ewerd/ECE_411_Team2_EpicDiceRoller/README.md

# ECE_411_Team2_EpicDiceRoller
ECE 411 Team 2 Practicum Project
