ewerd/ECE_411_Team2_EpicDiceRoller/docs/Presentation/ECE 411 Final Project Presentation.pdf

# Epic Dice Roller

## Designed and created by: Braden Harwood, Michael Weston, Stephen Short, Drew Seidel (Team 2 - ECE 411 -Fall 2021)

# Problem

Some common problems of ordinary dice…

- They are easy to lose
- Geometrical problems cause many sided dice to be very difficult to make and read
- They lack an interactive and dynamic way of revealing your roll and its implications on the game (i.e green flashing on a good roll, red on a bad)
- They lack history of dies rolled in case of forgetfulness
- They lack the ability to change the number of sides on a whim, leading one to need to own many dice sets

A positive attributes of dice that we don’t want to lose in our design:

- Hands on, the ability to physically feel, and roll dice by shaking
- Random result generation

# Vision and Motivation

The goal of our end product is to provide a fun, unique, and engaging way to roll dice for the majority of games that require dice, without eliminating the iconically unique feel of rolling the dice by means of shaking. The product is meant to serve as:

- An efficient and effective means of rolling a variety die sizes, as well as well as the number of die rolled, such that the device can be interchanged for traditional die on the vast majority of common games
- A novelty product. The Epic Dice Roller intends to enhance the dice rolling experience, giving the user fun and innovative feedback, methods for rolling, and methods for changing die size and number of die
- Provides a retro visual aesthetic, feel, and means of interacting with the device, without detracting from the positive features of traditional dice that we all know and love

# Objectives

By the end of this project, the goal was to have a not only functional, but nearing ready to move to production product design with a corresponding prototype to demonstrate that this is the case. The product we will unveil today has met the following objectives:

- Electrical design, functionality, and layout is functional and sound
- Power supply to device (9V battery) is simple, and accessible, and replaceable
- Device prototype is user friendly
- Demonstrates the ability to roll up to 9 dice at once
- Demonstrates an ability to be programmed via ICSP for firmware updates
- Demonstrates the ability to have the user change number of die rolled
- Demonstrates the ability to have the user change the dice size (d4, d6, d8, d10, d20, d100)
- Demonstrates that the user can roll dice using three different methods

# Alternatives

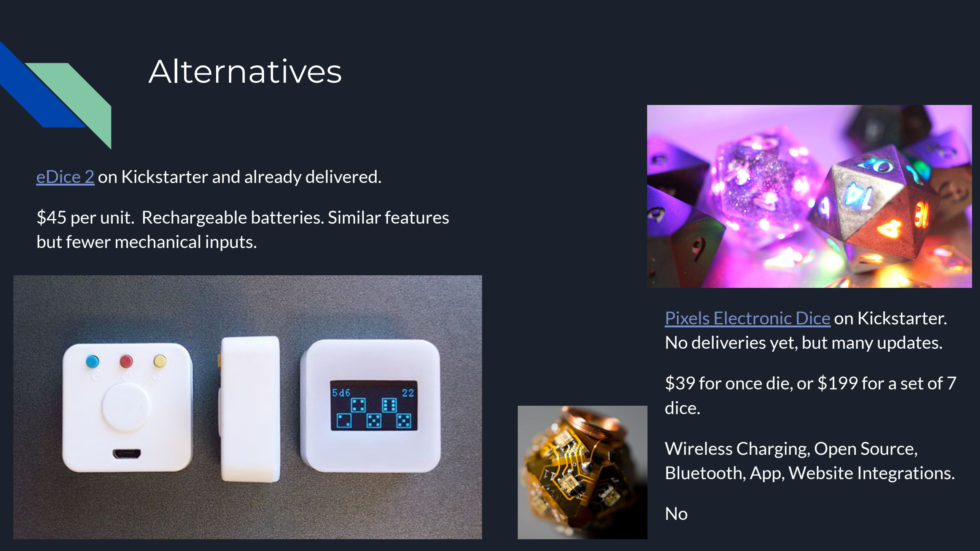
[picture p12: page 5]

eDice 2 (https://www.kickstarter.com/projects/1758784647/edice-2-an-universal-electronic-dice-for-tabletop-games) on Kickstarter and already delivered.

$45 per unit. Rechargeable batteries. Similar features but fewer mechanical inputs.

Pixels Electronic Dice (https://www.kickstarter.com/projects/pixels-dice/pixels-the-electronic-dice/) on Kickstarter. No deliveries yet, but many updates.

$39 for once die, or $199 for a set of 7 dice.

Wireless Charging, Open Source, Bluetooth, App, Website Integrations.

No

# Requirements

In designing this products, we set out the following goals:

Must:
- Simulate up to 9 dice at once
- Display total of dice
- Be able to preview size of dice and number of dice the user will be rolling
- Be powered from a batter
- Use a microprocessor

Should:
- Mount our microprocessor on our own PCB rather than a daughter board
- Have one compact PCB for the entire design
- Be programmable via on-board ICSP circuitry
- Provide users with at least three methods of dice rolling

May:
- Provide user with the individual result of each dice after a rol
- Allow the user to roll ‘fudge’ dice
- Display previous rolls.
- Have an enclosure.

We are two years ahead of schedule...
- Implement bluetooth to phone application to reveal roll
- Flashing LEDs on PCB
- Speaker on PCB for noise
- Voice activated

# Our Approach

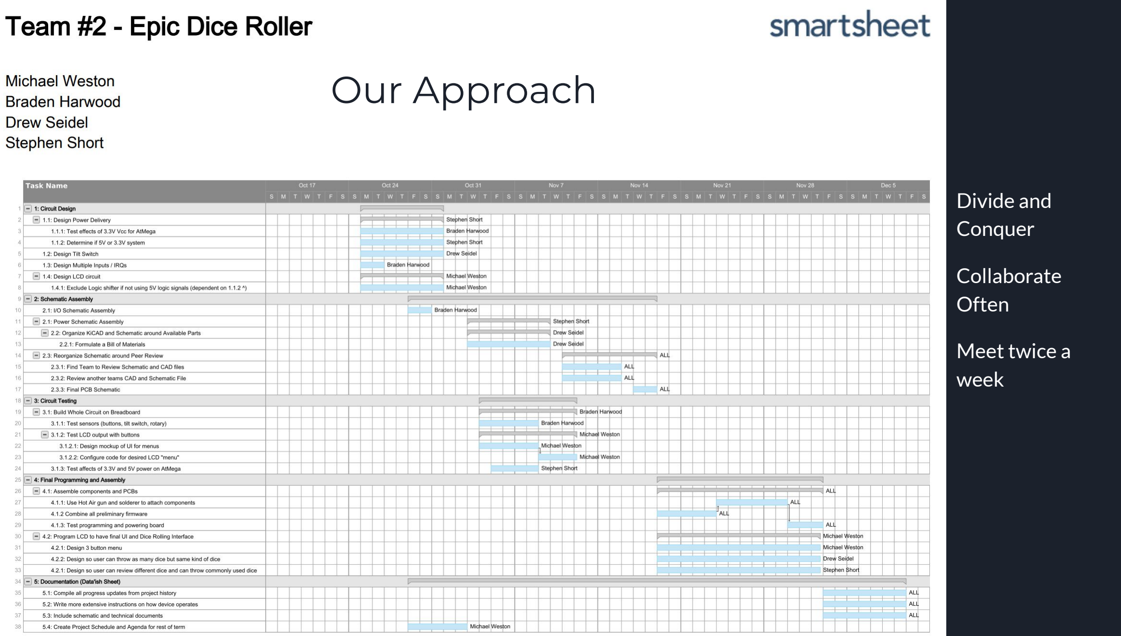
[picture p13: page 7]

Divide and
Conquer

Collaborate
Often

Meet twice a
week

# L0 Block Diagram

# L1 Block Diagram

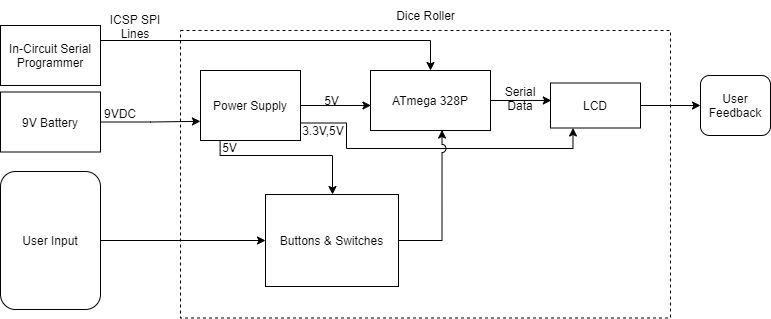
[picture p14: figure]

# Design - I/O and Chip Selection

Given the I/O components we selected, we elected to use the ATmega328P, given its cost, number of I/O pins, number of interrupt pins, and voltage specifications.

Our I/O circuits can be broken down into the following components/subsections.

Sensors:

- A toggle switch
- A single pole single throw power switch
- A single pole double throw toggle switch
- Four pushbuttons
- A rotary encoder with a top pushbutton
- A tilt switch

Actuator:

- An LCD screen

# Push Button

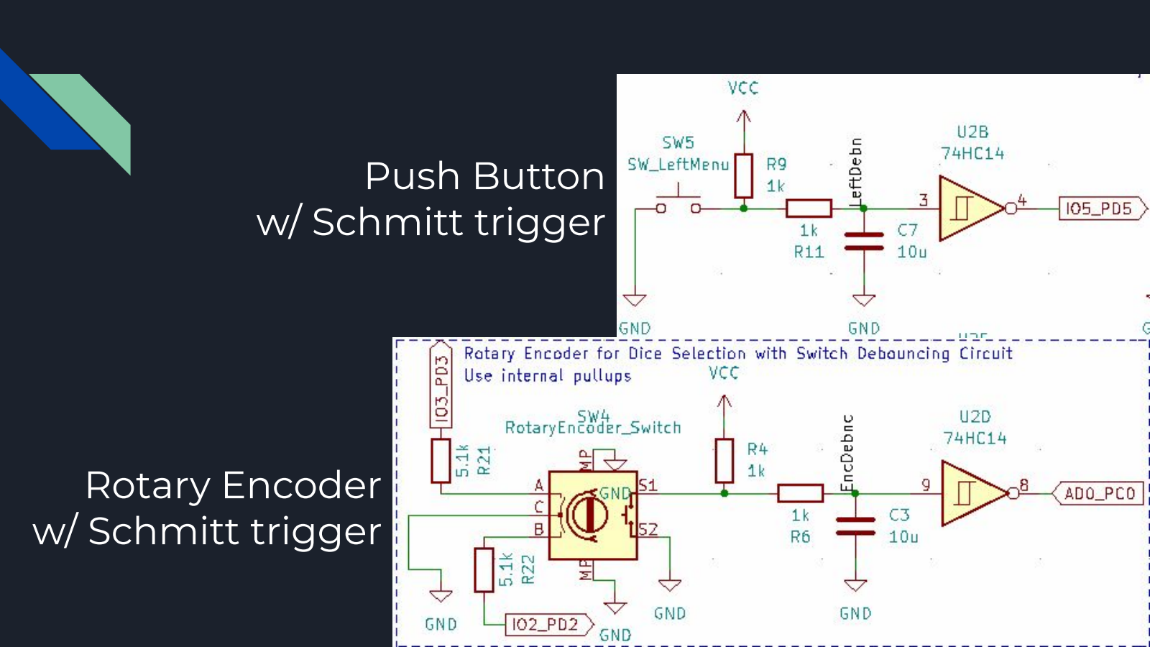
[picture p15: page 11]

# w/ Schmitt trigger

# Rotary Encoder w/ Schmitt trigger

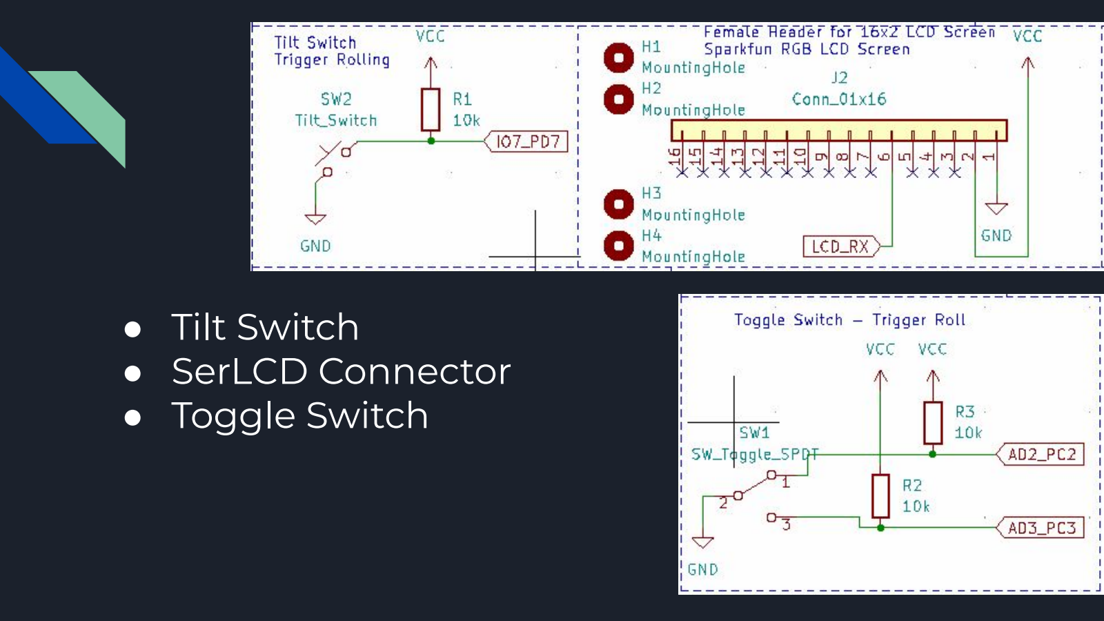
[picture p16: page 12]

# - Tilt Switch - SerLCD Connector - Toggle Switch

# ATMega328P

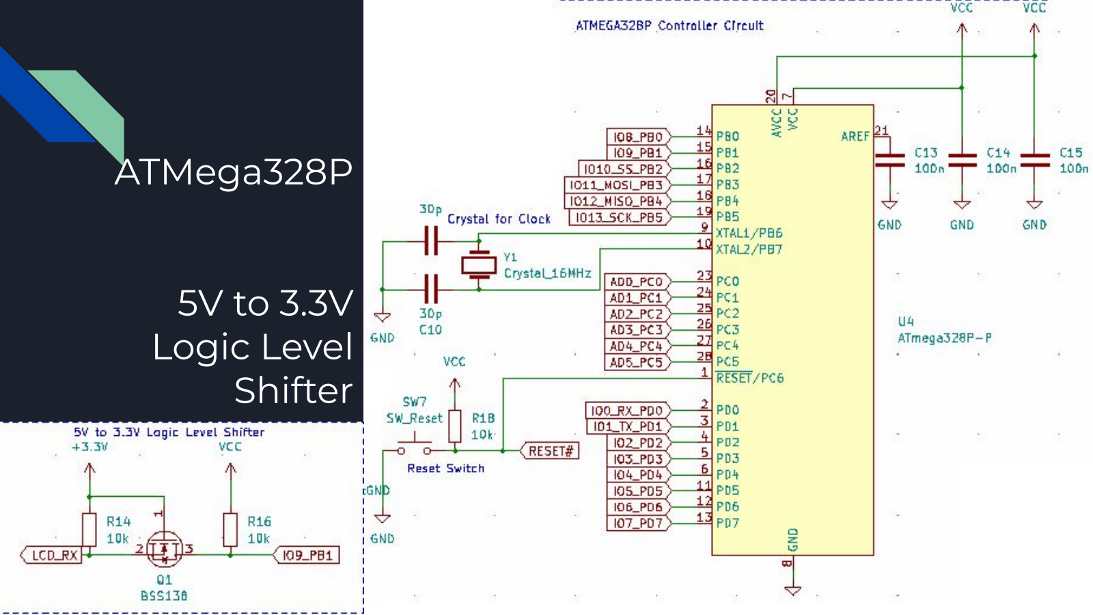
[picture p17: page 13]

# 5V to 3.3V Logic Level Shifter

# Design - Power Supply

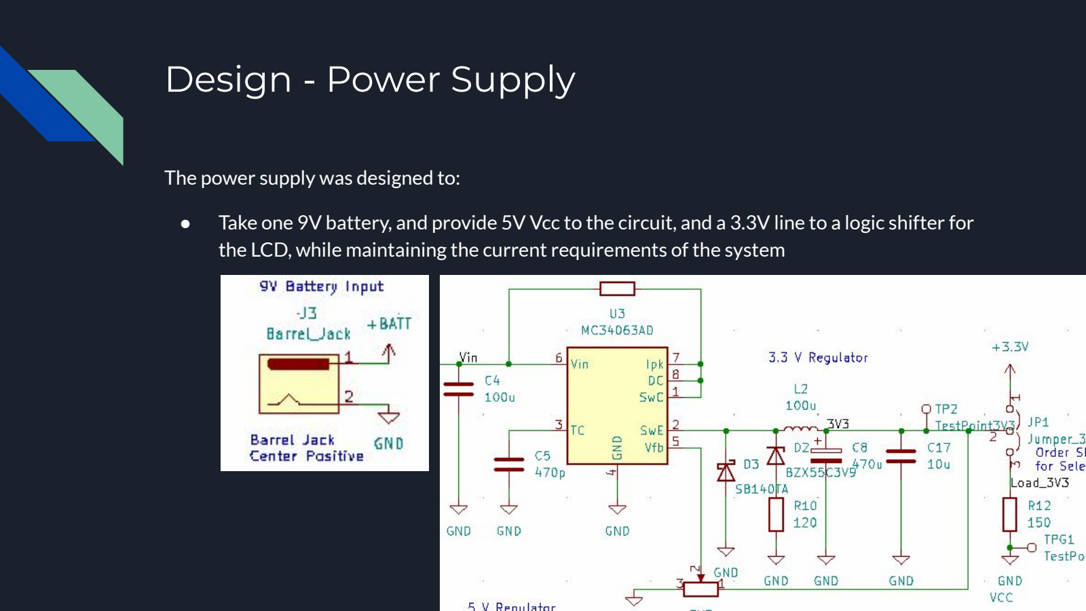
[picture p18: page 14]

The power supply was designed to:

- Take one 9V battery, and provide 5V Vcc to the circuit, and a 3.3V line to a logic shifter for the LCD, while maintaining the current requirements of the system

I am thinking we

# Implementation and Integration

# - Used LTSpice to simulate power supply

- Built sub circuits on breadboards for testing.

## - Power supply - Buttons & Schmitt trigger - Rotary Encoder - Tilt Switch - Logic Level Shifter and SerLCD screen

# Layout

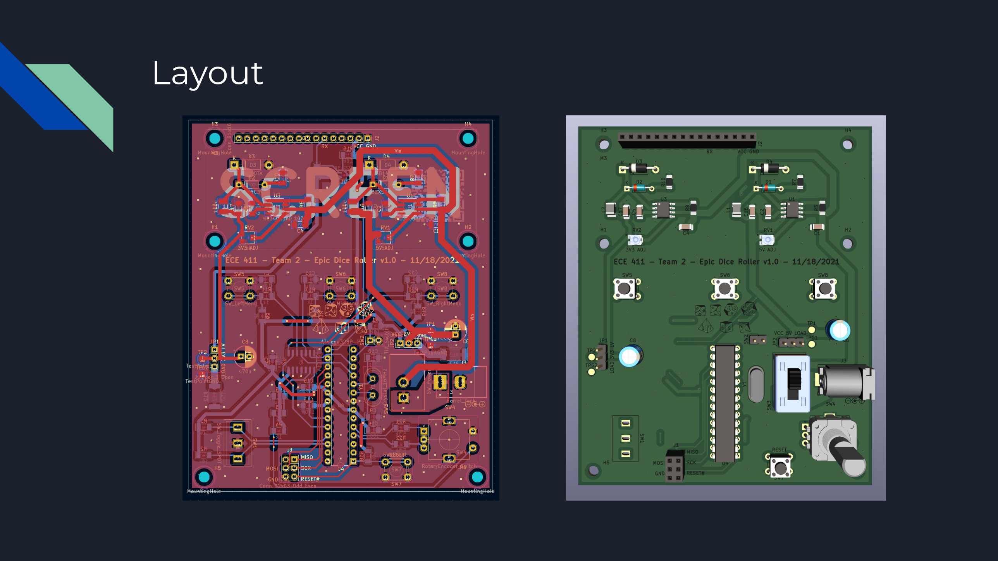
[picture p19: page 16]

# Bill of Materials

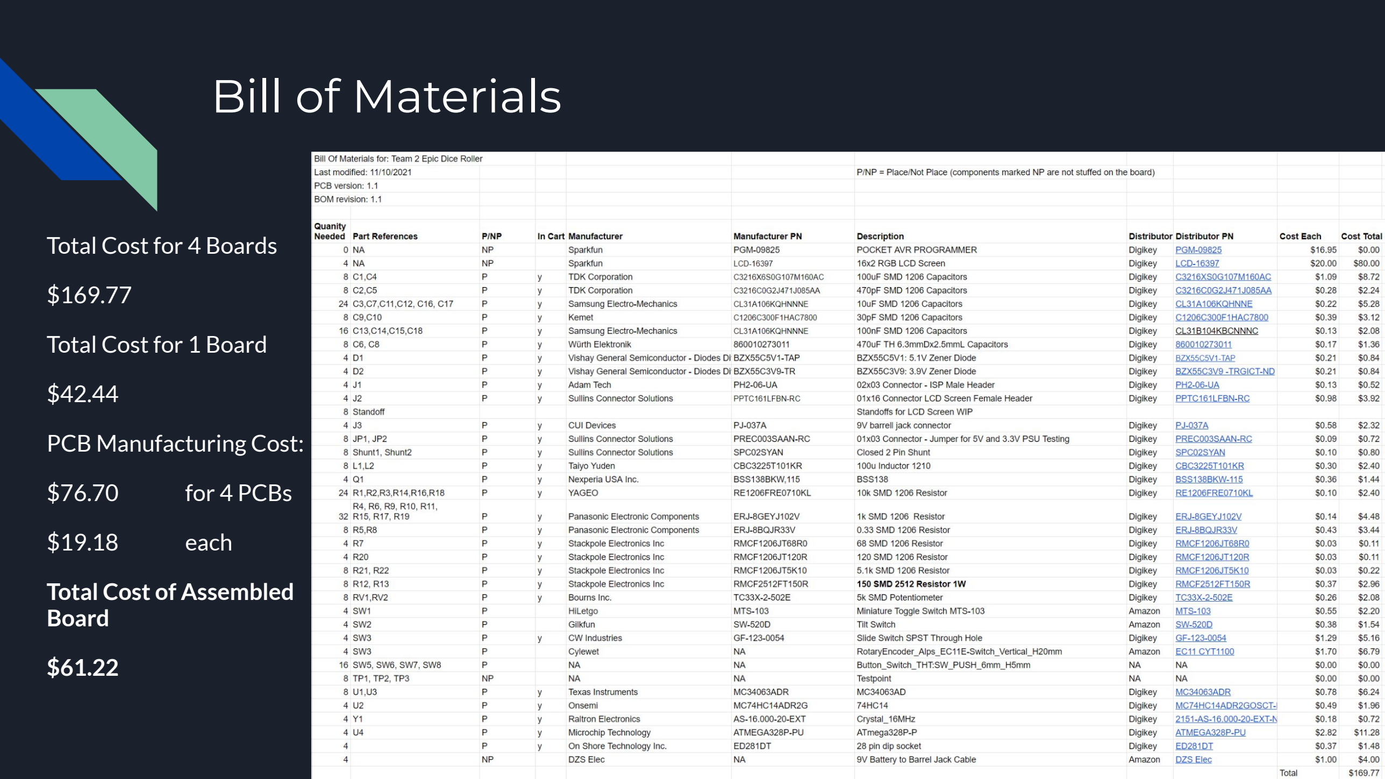
[picture p20: page 17]

Total Cost for 4 Boards

$169.77

Total Cost for 1 Board

$42.44

PCB Manufacturing Cost:

$76.70 | for 4 PCBs
$19.18 | each

Total Cost of Assembled
Board

$61.22

# Firmware - Code Overview

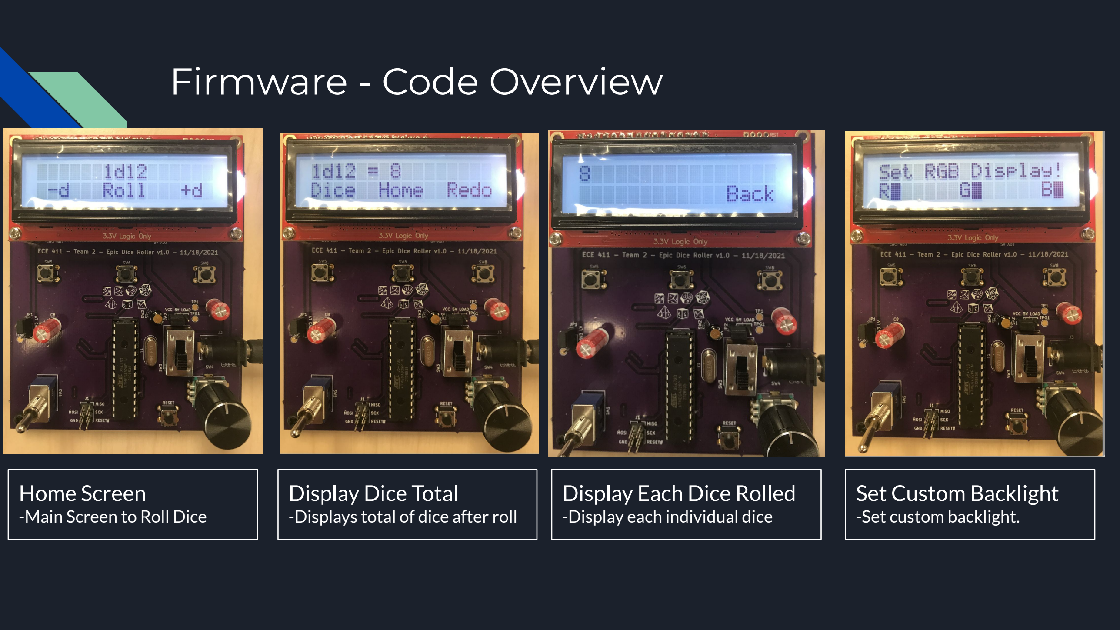
[picture p21: page 18]

Home Screen
-Main Screen to Roll Dice

Display Dice Total
-Displays total of dice after roll

Display Each Dice Rolled
-Display each individual dice

Set Custom Backlight
-Set custom backlight.

# IP and Prior Work

Braden’s Dice Roller v0

Arduino Bootloader (https://www.arduino.cc/en/Hacking/Bootloader?from=Tutorial.Bootloader) and IDE (https://www.arduino.cc/en/software)

Software Libraries: Entropy, (https://code.google.com/archive/p/avr-hardware-random-number-generation/) AltSoftSerial, (https://github.com/PaulStoffregen/AltSoftSerial) RotaryEncoder, (https://github.com/mathertel/RotaryEncoder) EnableInterrupt (https://github.com/GreyGnome/EnableInterrupt)

Sparkfun Logic Level Converter (https://www.sparkfun.com/products/12009)

Andrew Greenberg’s atmega328p Circuit Example (https://github.com/andrewgreenberg/eaglecad-workshop/tree/master/atmega328p-example)

Reference Design from MC34063ADR Datasheet

KiCAD v5.99 (https://www.kicad.org/)

LTSpice XVII (https://www.analog.com/en/design-center/design-tools-and-calculators/ltspice-simulator.html)

# Testing

We tested during each phase of the design process to ensure that the steps we were taking would yield a successful prototype:

Pre-PCB Development Stage:

- Tested the power supply design on breadboard
- Tested tilt switch, other I/O components on breadboard
- Developed a fully working breadboard prototype

During PCB Schematic and Layout Development:

- Multiple iterations, layouts by group members
- ERC tests
- DRC tests
- Design reviews

During PCB Bringup

- Soldered power supply first and tested to ensure success on each board
- Soldered I/O and tested electrical continuity, and validity of input/output functionality from sensors
- Tested electrical functionality of Rx line to LCD pins and it’s voltage level

Post PCB Bringup (Firmware Testing)

- Tested all modes to ensure functionality was as expected
- Interrogation of bugs
- Ensured that the random numbers were being generated, and die numbers were within range

# Results - Power Supply - 3.3V Output

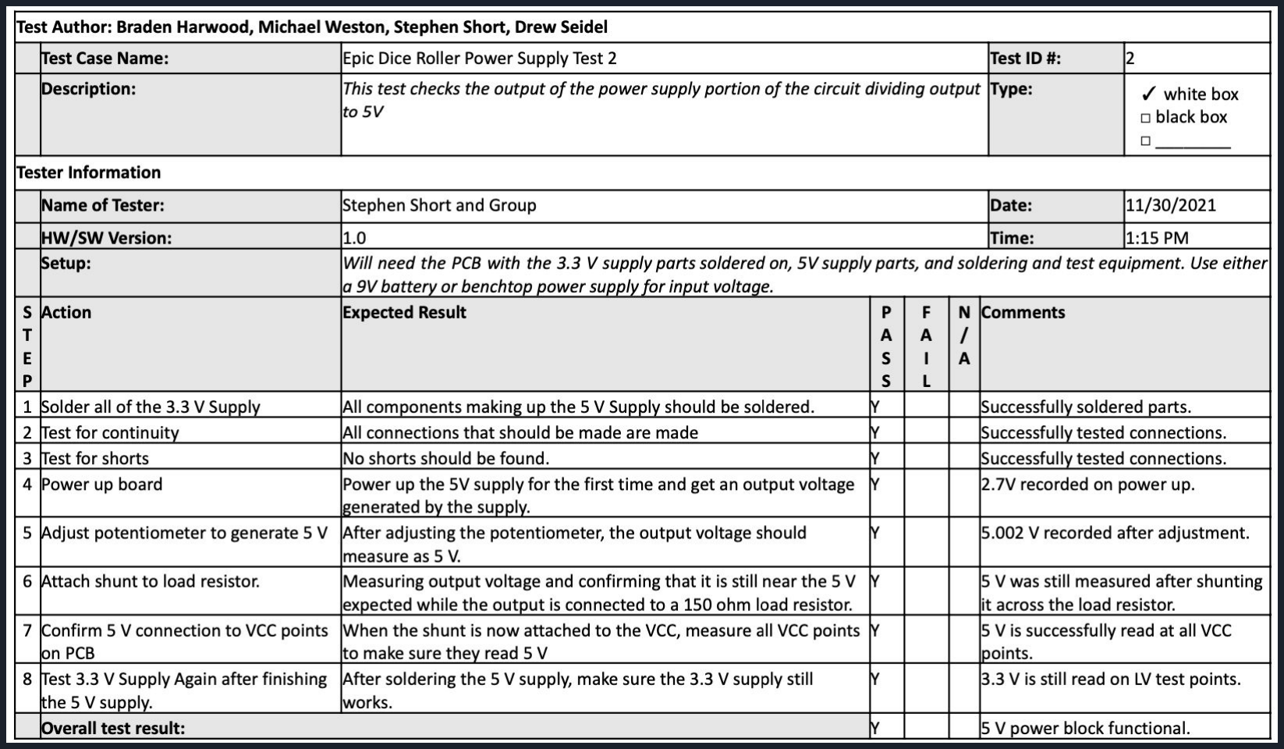
[picture p22: figure]

# Results - Power Supply - 5V Output

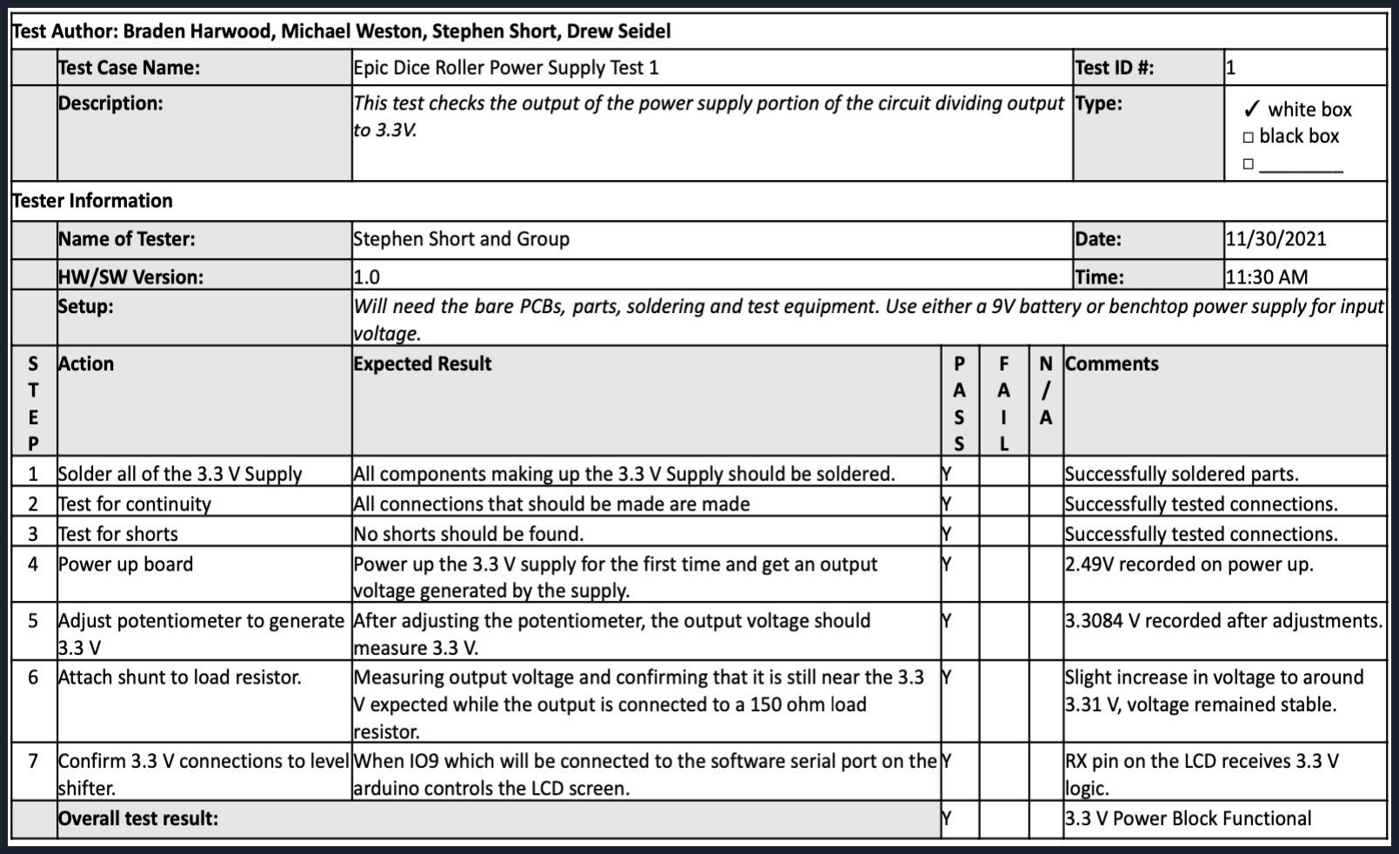
[picture p23: figure]

# Results - I/O Electrical Functionality

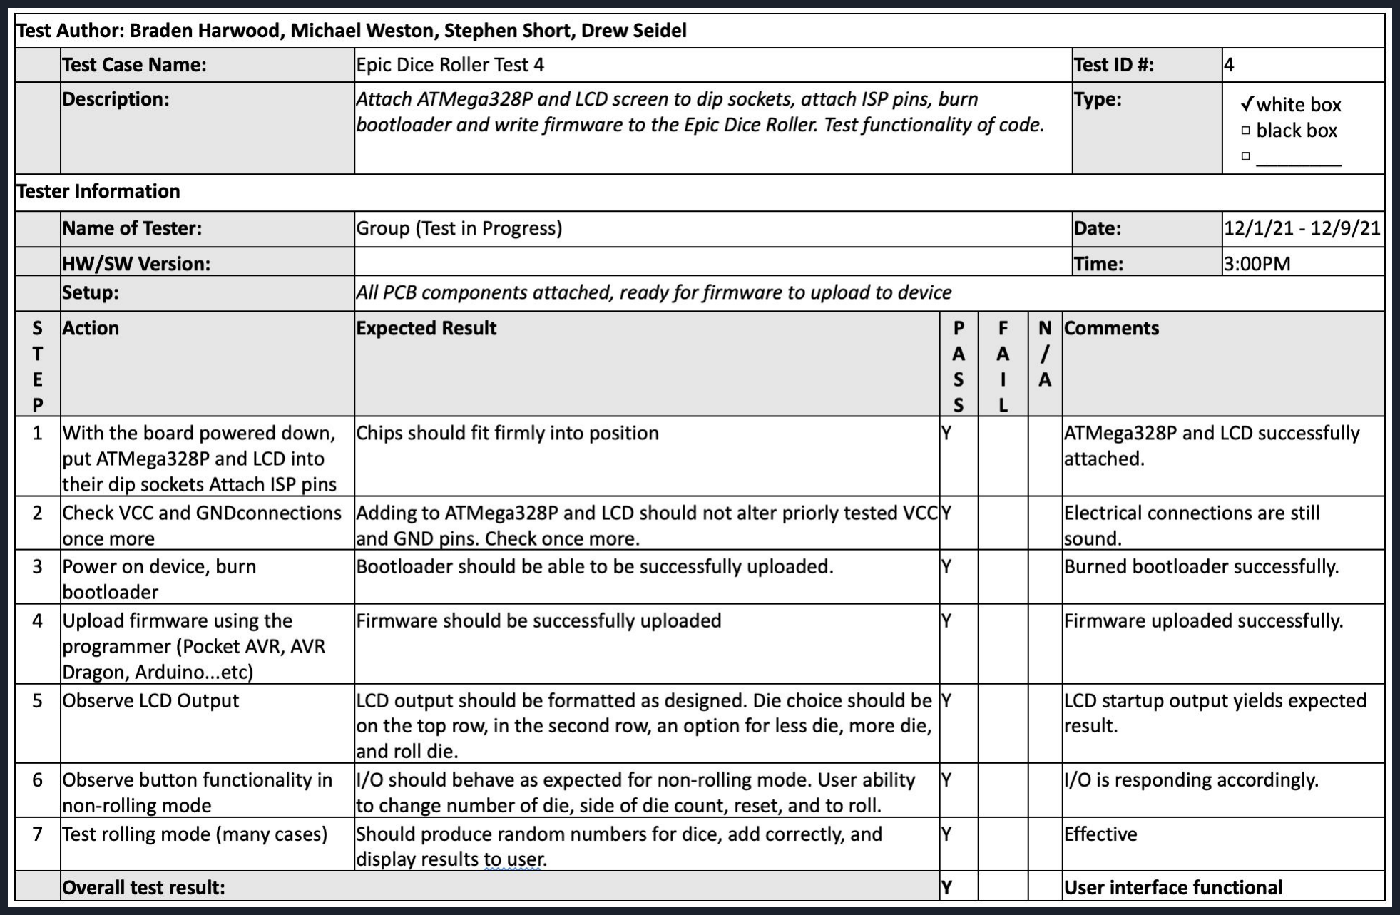
[picture p24: figure]

# Results - Firmware Testing and User Interface

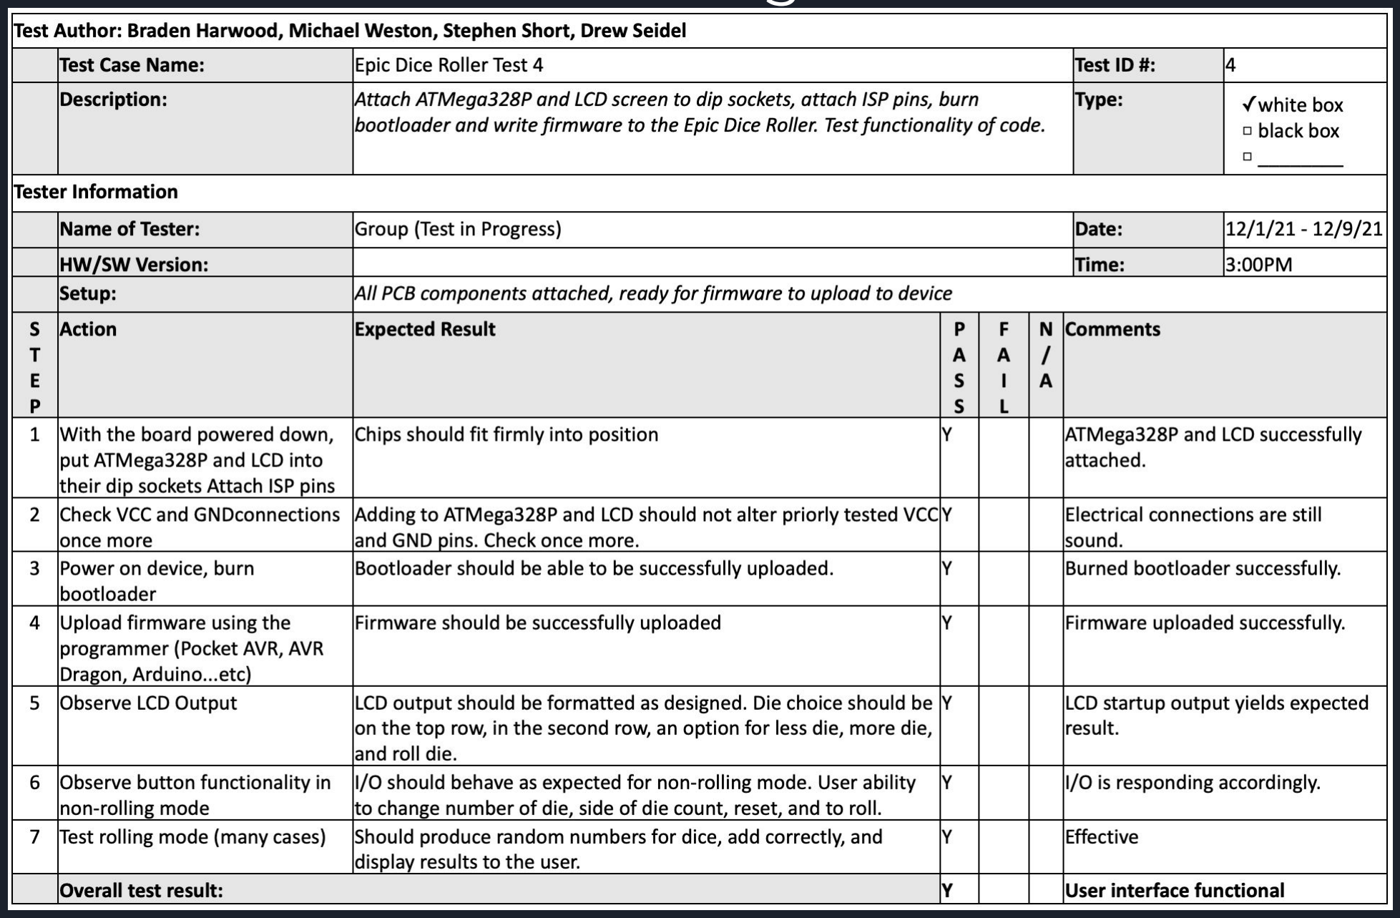
[picture p25: figure]

# Results and Issues

Fun Features:

- Color splashes when rolling really well or really poorly
- Tilt switch used to initiate a roll
- Several methods of rolling so user can pick their favorite method:
- Shake detection, button, pressing the rotary encoder
- User can customize the display color and even randomize the color utilizing the shake feature

Issues:

- Using software serial interface occasionally results in transmission being interrupted. Resulting in unexpected characters displayed to the LCD
- Lack of on board LEDs and serial output make it hard to debug during design.
- External pull ups for rotary encoder switch would’ve made testing easier.
- Power switch is would feel more natural if ‘ON’ was up
- Toggle switch footprint is slightly off.

# Contributions

Braden - I/O Testing and
Breadboarding, Schematic Capture and Layout, Hot Air Soldering Tutorial

Drew - BOM/Part Sourcing, Test Documentation, Tilt Switch Design/Testing

Michael - UI/UX Design, Firmware Development, and Scheduling

Stephen - P/S design (and redesign). PCB testing.

# What We Learned

Braden - KiCAD, PCB Layout

Drew -Hot air soldering with solder paste, PCB testing

Michael - Soldering / using solder paste, programing LCD for user, designing PCBs

Stephen - Buck regulator operation, hot air soldering with solder paste

If We Could Turn Back Time...

- Debounce the tilt switch
- Smaller form factor
- Use a rechargeable LiPo battery
- Use ATMega328P hardware for serial communication (either USART or SPI)
- Mount battery to board itself (on back or under screen)
- On board LEDs
- RickRoll QR Code...you know...for science!
- Sound effects
- Accessibility options
- Test point for SerLCD Rx signal
- Route reset button to reset SerLCD as well
