ewerd/ECE_411_Team2_EpicDiceRoller/CAD/Subsystems/Power Supply/Photos/BATT_to_ICSP.png

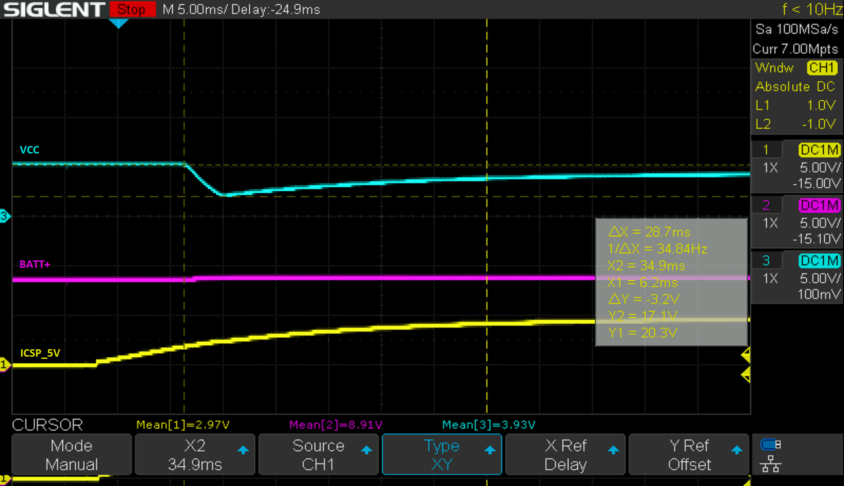
CAD/Subsystems/Power Supply/Photos/BATT_to_ICSP.png
