ewerd/ECE_411_Team2_EpicDiceRoller/CAD/Subsystems/Power Supply/Photos/Batt_TurnOn.png

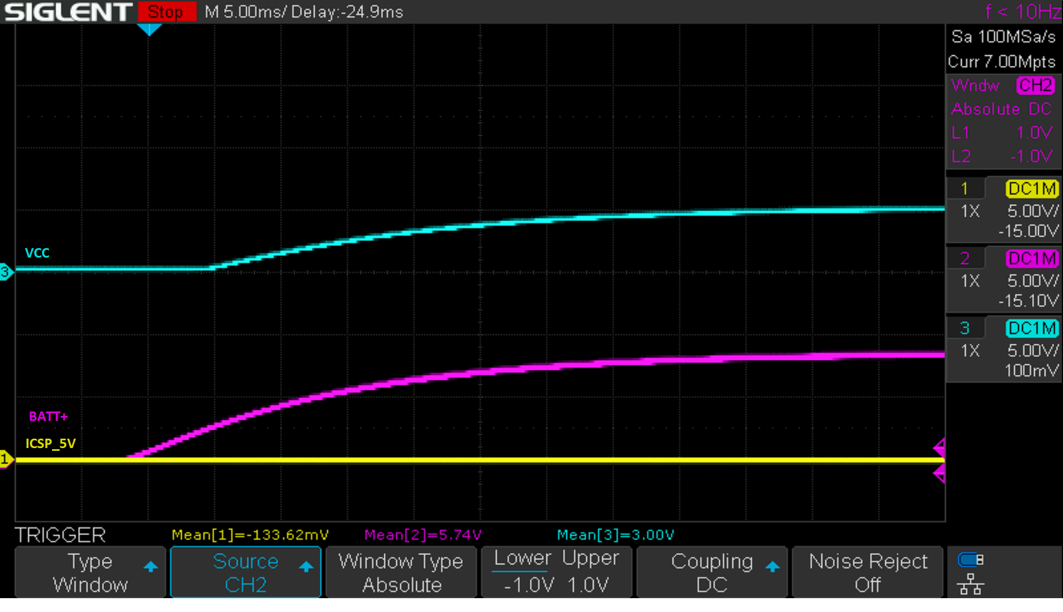
CAD/Subsystems/Power Supply/Photos/Batt_TurnOn.png
