ewerd/ECE_411_Team2_EpicDiceRoller/CAD/Subsystems/Power Supply/Photos/ICSP_to_BATT.png

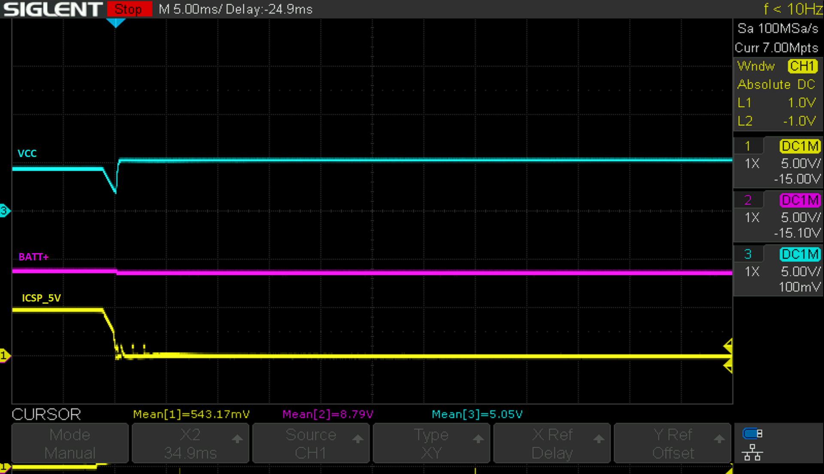
CAD/Subsystems/Power Supply/Photos/ICSP_to_BATT.png
