ewerd/ECE_411_Team2_EpicDiceRoller/CAD/Subsystems/Power Supply/Photos/ICSP_TurnOn.png

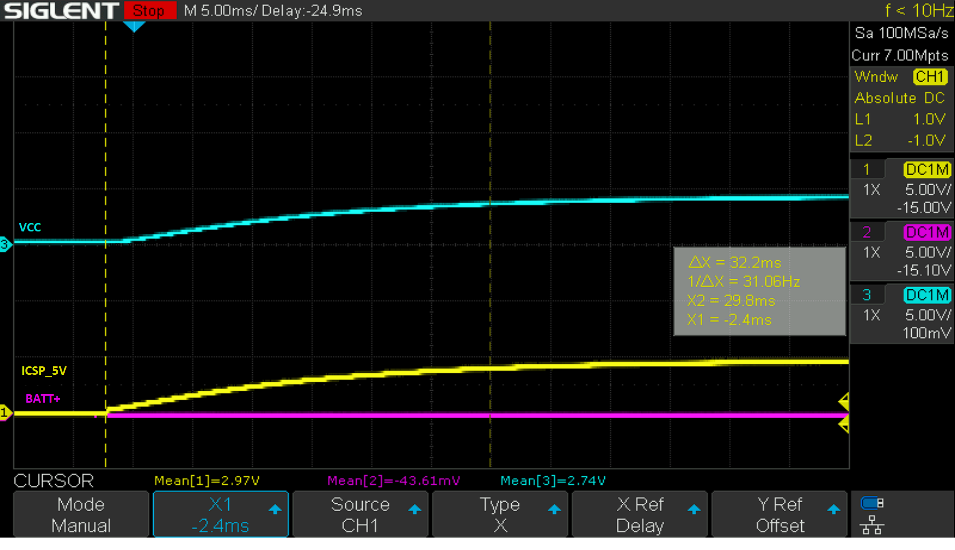
CAD/Subsystems/Power Supply/Photos/ICSP_TurnOn.png
