ewerd/ECE_411_Team2_EpicDiceRoller/CAD/Subsystems/Power Supply/Photos/PS_BB.jpg

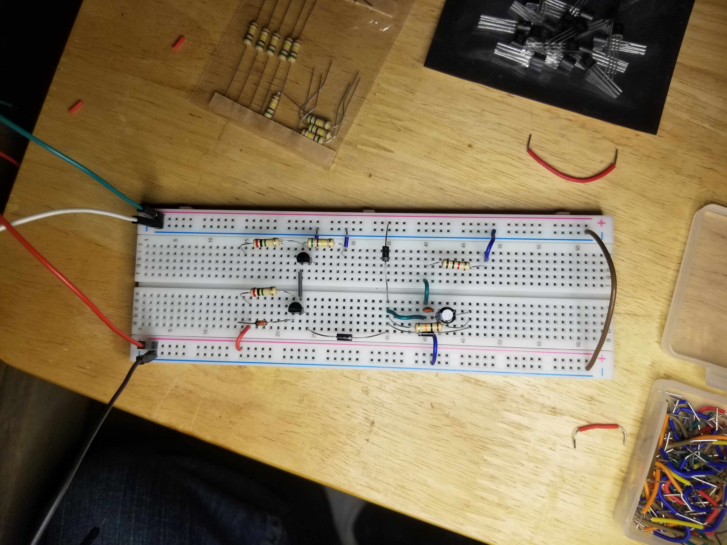
CAD/Subsystems/Power Supply/Photos/PS_BB.jpg
