ewerd/ECE_411_Team2_EpicDiceRoller/docs/Product Design Specification/L2_BlockDiag.drawio.png

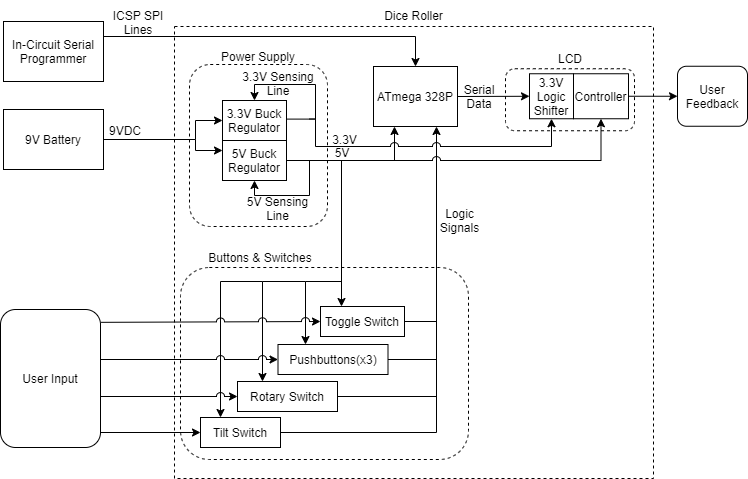
docs/Product Design Specification/L2_BlockDiag.drawio.png
