ewerd/ECE_411_Team2_EpicDiceRoller/docs/BOM/Bill of Materials.xlsx

Bill Of Materials for: Team 2 Epic Dice Roller
Last modified: 11/10/2021 |  |  |  |  |  | P/NP = Place/Not Place (components marked NP are not stuffed on the board)
PCB version: 1.1
BOM revision: 1.1
Quanity Needed | Part References | P/NP | In Cart | Manufacturer | Manufacturer PN | Description | Distributor | Distributor PN | Cost Each | Cost Total
0 | NA | NP |  | Sparkfun | PGM-09825 | POCKET AVR PROGRAMMER | Digikey | PGM-09825 (https://www.digikey.com/en/products/detail/sparkfun-electronics/PGM-09825/5230949) | $16.95 | $0.00
4 | NA | NP |  | Sparkfun | LCD-16397 | 16x2 RGB LCD Screen | Digikey | LCD-16397 (https://www.digikey.com/en/products/detail/sparkfun-electronics/LCD-16397/13171323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) | $20.00 | $80.00
8 | C1,C4 | P | y | TDK Corporation | C3216X6S0G107M160AC | 100uF SMD 1206 Capacitors | Digikey | C3216XS0G107M160AC (https://www.digikey.com/en/products/detail/tdk-corporation/C3216X6S0G107M160AC/2443490) | $1.09 | $8.72
8 | C2,C5 | P | y | TDK Corporation | C3216C0G2J471J085AA | 470pF SMD 1206 Capacitors | Digikey | C3216C0G2J471J085AA (https://www.digikey.com/en/products/detail/tdk-corporation/C3216C0G2J471J085AA/789734) | $0.28 | $2.24
24 | C3,C7,C11,C12, C16, C17 | P | y | Samsung Electro-Mechanics | CL31A106KQHNNNE | 10uF SMD 1206 Capacitors | Digikey | CL31A106KQHNNE (https://www.digikey.com/en/products/detail/samsung-electro-mechanics/CL31A106KQHNNNE/3886737) | $0.22 | $5.28
8 | C9,C10 | P | y | Kemet | C1206C300F1HAC7800 | 30pF SMD 1206 Capacitors | Digikey | C1206C300F1HAC7800 (https://www.digikey.com/en/products/detail/kemet/C1206C300F1HAC7800/7949915) | $0.39 | $3.12
16 | C13,C14,C15,C18 | P | y | Samsung Electro-Mechanics | CL31A106KQHNNNE | 100nF SMD 1206 Capacitors | Digikey | CL31B104KBCNNNC (https://www.digikey.com/en/products/detail/samsung-electro-mechanics/CL31B104KBCNNNC/3886675) | $0.13 | $2.08
8 | C6, C8 | P | y | Würth Elektronik | 860010273011 | 470uF TH 6.3mmDx2.5mmL Capacitors | Digikey | 860010273011 (https://www.digikey.com/en/products/detail/w%C3%BCrth-elektronik/860010273011/5728660) | $0.17 | $1.36
4 | D1 | P | y | Vishay General Semiconductor - Diodes Division | BZX55C5V1-TAP | BZX55C5V1: 5.1V Zener Diode | Digikey | BZX55C5V1-TAP (https://www.digikey.com/en/products/detail/vishay-general-semiconductor-diodes-division/BZX55C5V1-TAP/8564542) | $0.21 | $0.84
4 | D2 | P | y | Vishay General Semiconductor - Diodes Division | BZX55C3V9-TR | BZX55C3V9: 3.9V Zener Diode | Digikey | BZX55C3V9 -TRGICT-ND (https://www.digikey.com/en/products/detail/vishay-general-semiconductor-diodes-division/BZX55C3V9-TR/4828195) | $0.21 | $0.84
4 | J1 | P | y | Adam Tech | PH2-06-UA | 02x03 Connector - ISP Male Header | Digikey | PH2-06-UA (https://www.digikey.com/en/products/detail/adam-tech/PH2-06-UA/9830396) | $0.13 | $0.52
4 | J2 | P | y | Sullins Connector Solutions | PPTC161LFBN-RC | 01x16 Connector LCD Screen Female Header | Digikey | PPTC161LFBN-RC (https://www.digikey.com/en/products/detail/PPTC161LFBN-RC/S7014-ND/810154?itemSeq=381371106) | $0.98 | $3.92
8 | Standoff |  |  |  |  | Standoffs for LCD Screen WIP
4 | J3 | P | y | CUI Devices | PJ-037A | 9V barrell jack connector | Digikey | PJ-037A (https://www.digikey.com/en/products/detail/cui-devices/PJ-037A/1644545) | $0.58 | $2.32
8 | JP1, JP2 | P | y | Sullins Connector Solutions | PREC003SAAN-RC | 01x03 Connector - Jumper for 5V and 3.3V PSU Testing | Digikey | PREC003SAAN-RC (https://www.digikey.com/en/products/detail/sullins-connector-solutions/PREC003SAAN-RC/2774851) | $0.09 | $0.72
8 | Shunt1, Shunt2 | P | y | Sullins Connector Solutions | SPC02SYAN | Closed 2 Pin Shunt | Digikey | SPC02SYAN (https://www.digikey.com/en/products/detail/sullins-connector-solutions/SPC02SYAN/76375) | $0.10 | $0.80
8 | L1,L2 | P | y | Taiyo Yuden | CBC3225T101KR | 100u Inductor 1210 | Digikey | CBC3225T101KR (https://www.digikey.com/en/products/detail/taiyo-yuden/CBC3225T101KR/2763317) | $0.30 | $2.40
4 | Q1 | P | y | Nexperia USA Inc. | BSS138BKW,115 | BSS138 | Digikey | BSS138BKW-115 (https://www.digikey.com/en/products/detail/nexperia-usa-inc/BSS138BKW-115/2779824) | $0.36 | $1.44
24 | R1,R2,R3,R14,R16,R18 | P | y | YAGEO | RE1206FRE0710KL | 10k SMD 1206 Resistor | Digikey | RE1206FRE0710KL (https://www.digikey.com/en/products/detail/yageo/RE1206FRE0710KL/5924263) | $0.10 | $2.40
32 | R4, R6, R9, R10, R11, R15, R17, R19 | P | y | Panasonic Electronic Components | ERJ-8GEYJ102V | 1k SMD 1206 Resistor | Digikey | ERJ-8GEYJ102V (https://www.digikey.com/en/products/detail/panasonic-electronic-components/ERJ-8GEYJ102V/10364) | $0.14 | $4.48
8 | R5,R8 | P | y | Panasonic Electronic Components | ERJ-8BQJR33V | 0.33 SMD 1206 Resistor | Digikey | ERJ-8BQJR33V (https://www.digikey.com/en/products/detail/panasonic-electronic-components/ERJ-8BQJR33V/5647699) | $0.43 | $3.44
4 | R7 | P | y | Stackpole Electronics Inc | RMCF1206JT68R0 | 68 SMD 1206 Resistor | Digikey | RMCF1206JT68R0 (https://www.digikey.com/en/products/detail/stackpole-electronics-inc/RMCF1206JT68R0/1753872) | $0.03 | $0.11
4 | R20 | P | y | Stackpole Electronics Inc | RMCF1206JT120R | 120 SMD 1206 Resistor | Digikey | RMCF1206JT120R (https://www.digikey.com/en/products/detail/stackpole-electronics-inc/RMCF1206JT120R/1757405) | $0.03 | $0.11
8 | R21, R22 | P | y | Stackpole Electronics Inc | RMCF1206JT5K10 | 5.1k SMD 1206 Resistor | Digikey | RMCF1206JT5K10 (https://www.digikey.com/en/products/detail/stackpole-electronics-inc/RMCF1206JT5K10/1753850) | $0.03 | $0.22
8 | R12, R13 | P | y | Stackpole Electronics Inc | RMCF2512FT150R | 150 SMD 2512 Resistor 1W | Digikey | RMCF2512FT150R (https://www.digikey.com/en/products/detail/stackpole-electronics-inc/RMCF2512FT150R/1716491) | $0.37 | $2.96
8 | RV1,RV2 | P | y | Bourns Inc. | TC33X-2-502E | 5k SMD Potentiometer | Digikey | TC33X-2-502E (https://www.digikey.com/en/products/detail/bourns-inc/TC33X-2-502E/612861) | $0.26 | $2.08
4 | SW1 | P |  | HiLetgo | MTS-103 | Miniature Toggle Switch MTS-103 | Amazon | MTS-103 (https://www.amazon.com/dp/B079JG2YSM?psc=1&ref=ppx_yo2_dt_b_product_details) | $0.55 | $2.20
4 | SW2 | P |  | Gilkfun | SW-520D | Tilt Switch | Amazon | SW-520D (https://www.amazon.com/dp/B00RGN0KY0?psc=1&ref=ppx_yo2_dt_b_product_details) | $0.38 | $1.54
4 | SW3 | P | y | CW Industries | GF-123-0054 | Slide Switch SPST Through Hole | Digikey | GF-123-0054 (https://www.digikey.com/en/products/detail/cw-industries/GF-123-0054/4089770) | $1.29 | $5.16
4 | SW3 | P |  | Cylewet | NA | RotaryEncoder_Alps_EC11E-Switch_Vertical_H20mm | Amazon | EC11 CYT1100 (https://www.amazon.com/dp/B07DM2YMT4?psc=1&ref=ppx_yo2_dt_b_product_details) | $1.70 | $6.79
16 | SW5, SW6, SW7, SW8 | P |  | NA | NA | Button_Switch_THT:SW_PUSH_6mm_H5mm | NA | NA | $0.00 | $0.00
8 | TP1, TP2, TP3 | NP |  | NA | NA | Testpoint | NA | NA | $0.00 | $0.00
8 | U1,U3 | P | y | Texas Instruments | MC34063ADR | MC34063AD | Digikey | MC34063ADR (https://www.digikey.com/en/products/detail/texas-instruments/MC34063ADR/717431) | $0.78 | $6.24
4 | U2 | P | y | Onsemi | MC74HC14ADR2G | 74HC14 | Digikey | MC74HC14ADR2GOSCT-ND (https://www.digikey.com/en/products/detail/MC74HC14ADR2G/MC74HC14ADR2GOSCT-ND/1139718?itemSeq=381371814) | $0.49 | $1.96
4 | Y1 | P | y | Raltron Electronics | AS-16.000-20-EXT | Crystal_16MHz | Digikey | 2151-AS-16.000-20-EXT-ND (https://www.digikey.com/en/products/detail/raltron-electronics/AS-16-000-20-EXT/10246238) | $0.18 | $0.72
4 | U4 | P | y | Microchip Technology | ATMEGA328P-PU | ATmega328P-P | Digikey | ATMEGA328P-PU (https://www.digikey.com/en/products/detail/microchip-technology/ATMEGA328P-PU/1914589) | $2.82 | $11.28
4 |  | P | y | On Shore Technology Inc. | ED281DT | 28 pin dip socket | Digikey | ED281DT (https://www.digikey.com/en/products/detail/on-shore-technology-inc/ED281DT/4147600) | $0.37 | $1.48
4 |  | NP |  | DZS Elec | NA | 9V Battery to Barrel Jack Cable | Amazon | DZS Elec (https://www.amazon.com/dp/B07FDS11ZY?psc=1&ref=ppx_yo2_dt_b_product_details) | $1.00 | $4.00
 |  |  |  |  |  |  |  |  | Total | $169.77
