ewerd/ECE_411_Team2_EpicDiceRoller/(threads)

Thread 2 (2021-12-09):

PCB Layout Improvements

zorcat27, 2021-12-09:
These are the errors we found while assembling the board and bringing them up for testing:
Toggle Switch - One pin offset was slightly longer making it to where 2 pins fit well and the third had to be heated a little and bent into the hole.
Slide Power Switch - Power is on when the switch is down rather than up. A quick flip would fix this.
ISP Header - Header was oriented incorrectly for the programmer to be accessed via the front of the board. Headers going out the bottom would have worked, but the workaround was to use male to female jumpers to transfer the signals from the programmer to the flipped ISP pins.
Rotary Encoder Signal Pins - Use internal pull up resistors, would make testing easier if we used an external pull up resistor. Adding a test point for these would be helpful to confirm with an oscilloscope.
No power LEDs on the board - Would be helpful to indicate that power was being received on the input and generated on the 3.3 V and 5 V power supply circuits.

Thread 3 (2021-12-09):

PCB Improvements

zorcat27, 2021-12-09:
Convert board to use and charge with a 3.7 V lipo battery. Requires changing the power supply and reducing voltage to 3.3 V throughout but also removes the 3.3 V logic level shifter on the LCD.
Add physical debounce connection to the tilt switch and make it optional by using a 0 ohm resistor jumper.
Consider a different protocol for communicating with the LCD screen since there are bugs sometimes in the display.
