ewerd/ECE_411_Team2_EpicDiceRoller/Team #2 - Epic Dice Roller Schedule.pdf

# Team #2 - Epic Dice Roller

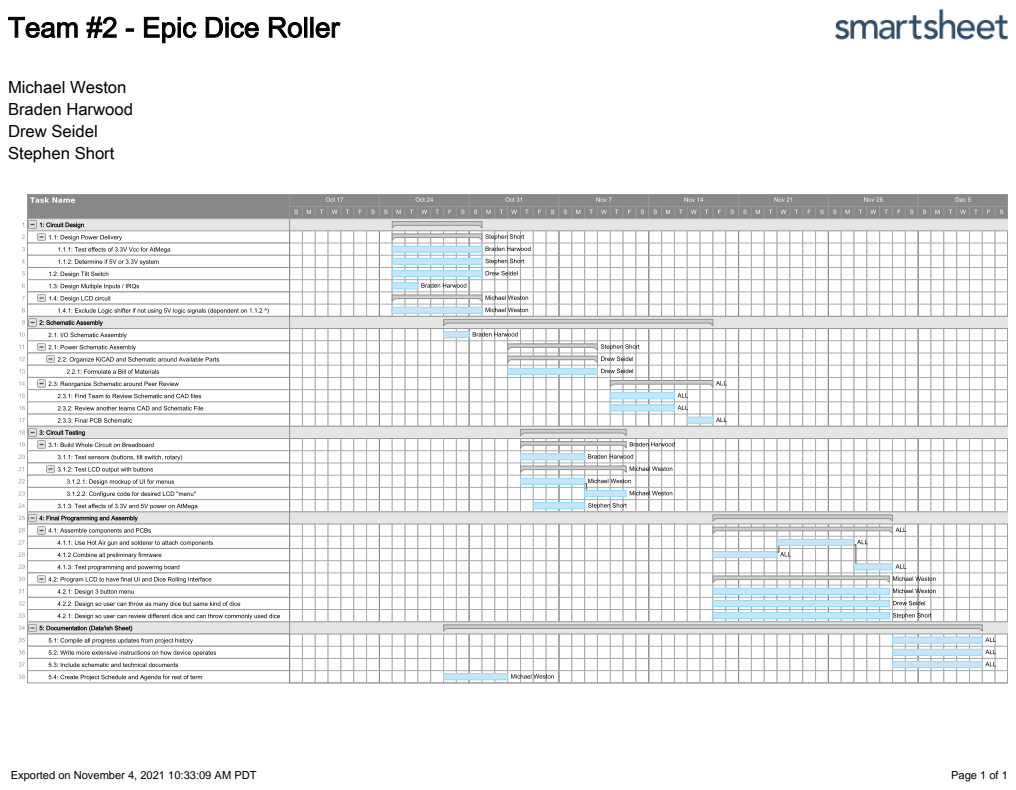
[picture p32: page 1]
Michael Weston Braden Harwood Drew Seidel Stephen Short; Exported on November 4, 2021 10:33:09 AM PDT; Page 1 of
