ewerd/ECE_411_Team2_EpicDiceRoller/CAD/Subsystems/Power Supply/Schematics/DiceRoller_PS.asc

C1: cap; 1µ
C2: cap; 10p
D1: diode
D2: diode
D3: zener; ZD30
D4: diode
M1: nmos; BS170
Q1: npn
R1: res; 2Meg
R2: res; 500k
R3: res; 2Meg
R4: res; 10k
RLoad: res; {RLoad}
V1: voltage; PULSE(0 {VBatt} 1 1p 1p 1 2); Rser=50m
V2: voltage; PULSE(0 5 0 1p 1p 2 4); Rser=50m
Named nets: Bat, ICSP, 0, VLoad
.param RLoad=1k
.param VBatt=9
.tran 0 4 0 10m
Could use zener as voltage regulator
.model BS170 ako:BSS123 Vto=2.1
.model ZD30 ako:1N750 bv=3 vpk=3
