ewerd/ECE_411_Team2_EpicDiceRoller/CAD/Team2EpicDiceRoller/Team2EpicDiceRoller.kicad_pcb

## KiCad design CAD/Team2EpicDiceRoller/Team2EpicDiceRoller.kicad_pcb (2021-12-05)

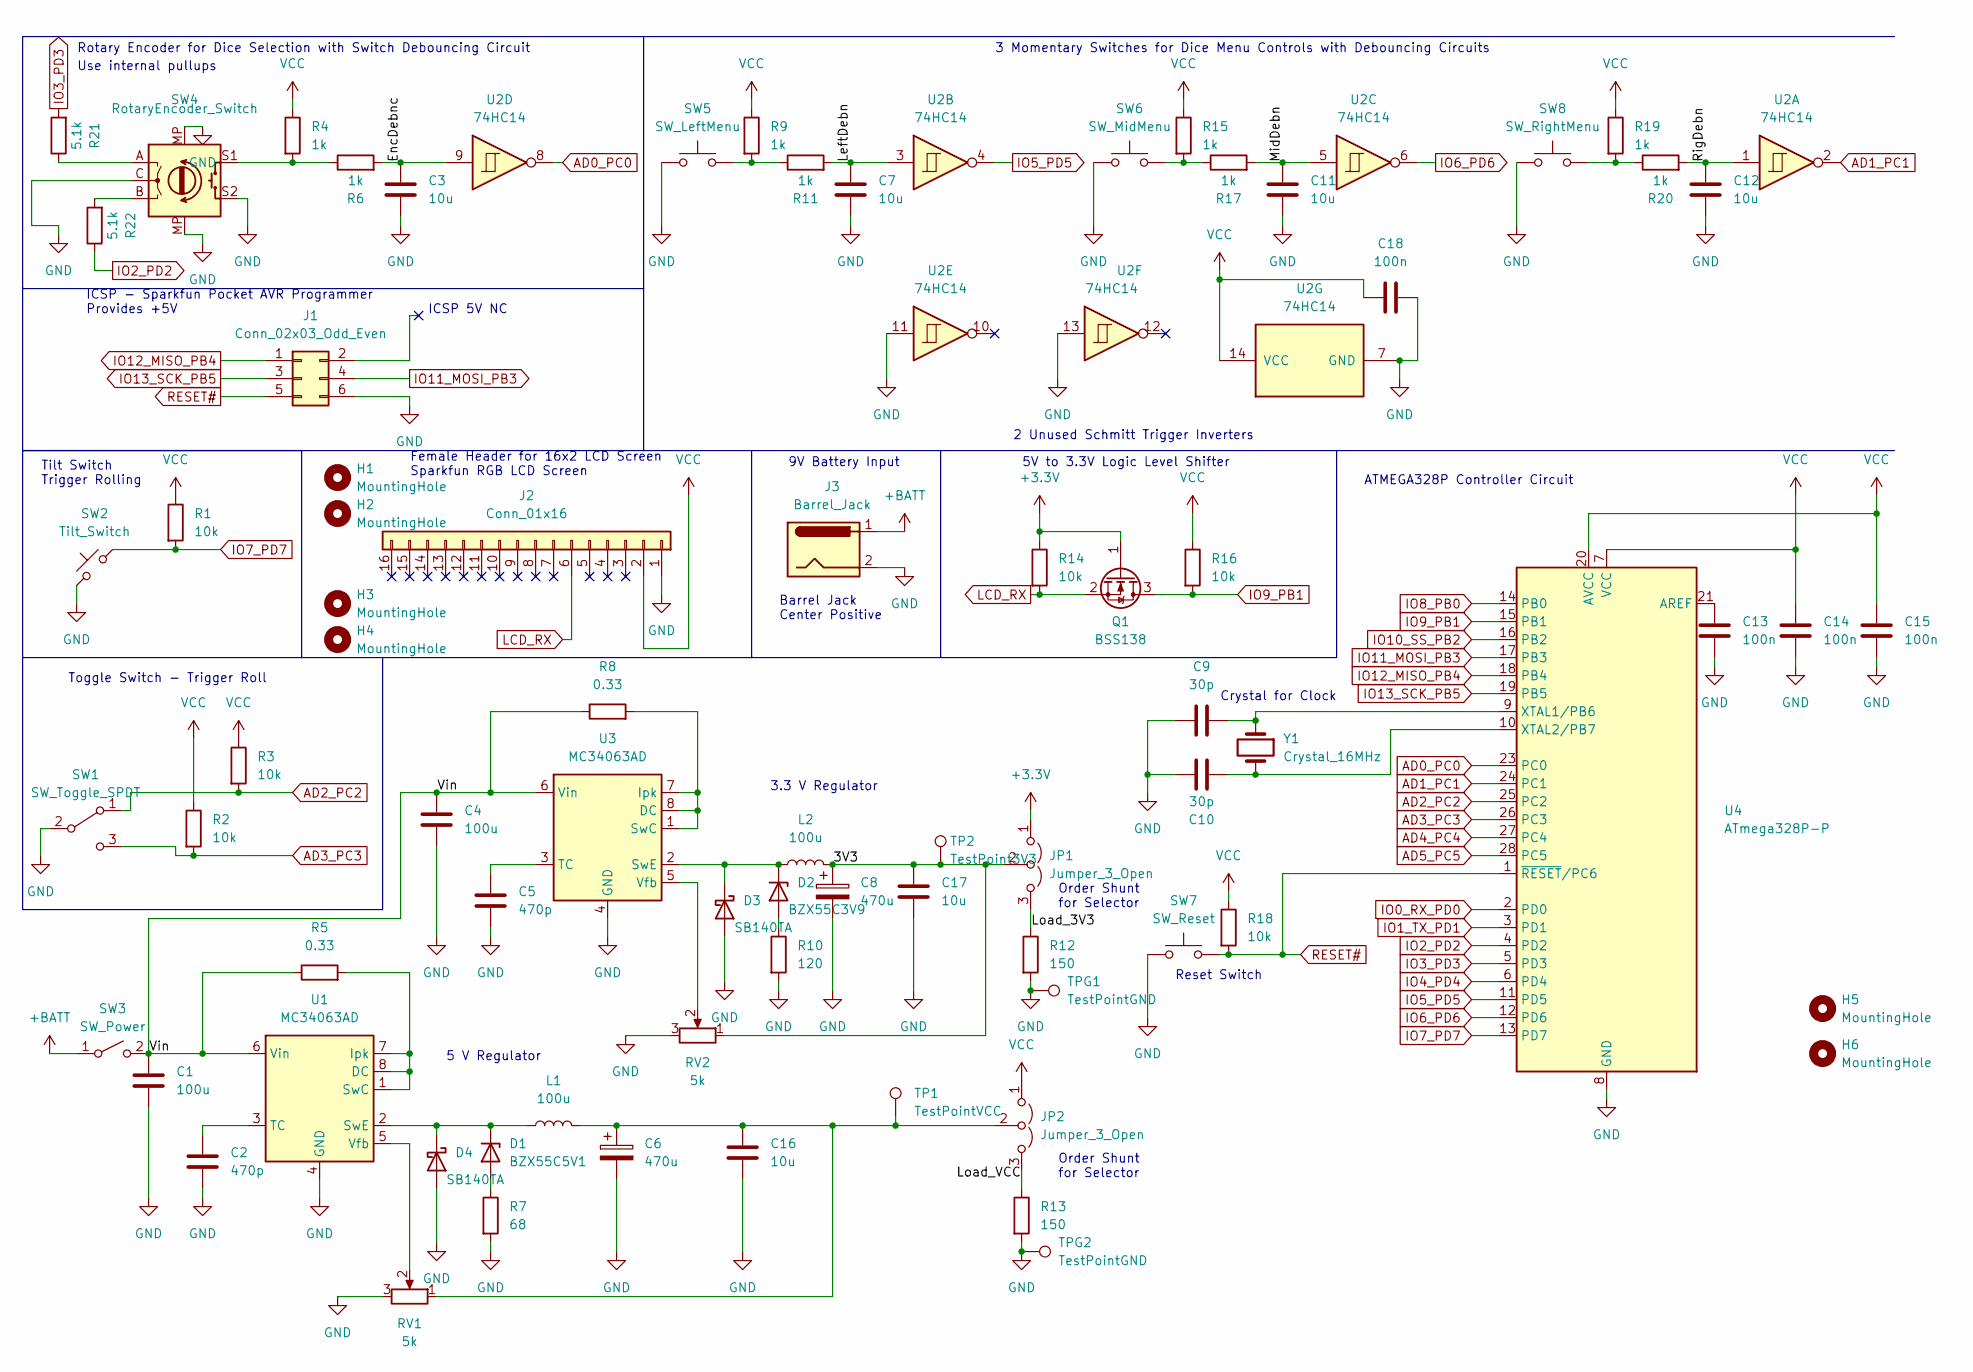
[picture p33: schematic Team2EpicDiceRoller.kicad_sch, Team 2 - Epic Dice Roller Schematic]

Parts:
C1, C4: 100u; C_1206_3216Metric_Pad1.33x1.80mm_HandSolder
C2, C5: 470p; C_1206_3216Metric_Pad1.33x1.80mm_HandSolder
C3, C7, C11, C12, C16, C17: 10u; C_1206_3216Metric_Pad1.33x1.80mm_HandSolder
C6, C8: 470u; CP_Radial_D6.3mm_P2.50mm
C9, C10: 30p; C_1206_3216Metric_Pad1.33x1.80mm_HandSolder
C13, C14, C15, C18: 100n; C_1206_3216Metric_Pad1.33x1.80mm_HandSolder
D1: BZX55C5V1; D_DO-35_SOD27_P7.62mm_Horizontal
D2: BZX55C3V9; D_DO-35_SOD27_P7.62mm_Horizontal
D3, D4: SB140TA; D_DO-41_SOD81_P10.16mm_Horizontal
H1, H2, H3, H4, H5, H6: MountingHole; MountingHole_3.2mm_M3
J1: Conn_02x03_Odd_Even; PinSocket_2x03_P2.54mm_Vertical
J2: Conn_01x16; PinSocket_1x16_P2.54mm_Vertical_LCD
J3: Barrel_Jack; BarrelJack_CUI_PJ-037A_Horizontal
JP1, JP2: Jumper_3_Open; PinHeader_1x03_P2.54mm_Vertical
L1, L2: 100u; L_1210_3225Metric_Pad1.42x2.65mm_HandSolder
Q1: BSS138; SOT-323_SC-70_Handsoldering
R1, R2, R3, R14, R16, R18: 10k; R_1206_3216Metric_Pad1.30x1.75mm_HandSolder
R4, R6, R9, R11, R15, R17, R19, R20: 1k; R_1206_3216Metric_Pad1.30x1.75mm_HandSolder
R5, R8: 0.33; R_1206_3216Metric_Pad1.30x1.75mm_HandSolder
R7: 68; R_1206_3216Metric_Pad1.30x1.75mm_HandSolder
R10: 120; R_1206_3216Metric_Pad1.30x1.75mm_HandSolder
R12, R13: 150; R_2512_6332Metric_Pad1.40x3.35mm_HandSolder
R21, R22: 5.1k; R_1206_3216Metric_Pad1.30x1.75mm_HandSolder
RV1, RV2: 5k; TRIM_TC33X-2-502E
SW1: SW_Toggle_SPDT; GoldSun_MTS103_Mini_Toggle_Switch
SW2: Tilt_Switch; PinHeader_1x02_P2.54mm_Vertical
SW3: SW_Power; SW_GF-123-0054
SW4: RotaryEncoder_Switch; RotaryEncoder_Alps_EC11E-Switch_Vertical_H20mm
SW5: SW_LeftMenu; SW_PUSH_6mm_H5mm
SW6: SW_MidMenu; SW_PUSH_6mm_H5mm
SW7: SW_Reset; SW_PUSH_6mm_H5mm
SW8: SW_RightMenu; SW_PUSH_6mm_H5mm
TP1: TestPointVCC; TestPoint_Pad_D2.0mm
TP2: TestPoint3V3; TestPoint_Pad_D2.0mm
TPG1, TPG2: TestPointGND; TestPoint_Pad_D2.0mm
U1, U3: MC34063AD; SOIC-8_3.9x4.9mm_P1.27mm
U2: 74HC14; SOIC-14_3.9x8.7mm_P1.27mm
U4: ATmega328P-P; DIP-28_W7.62mm
Y1: Crystal_16MHz; Crystal_HC49-4H_Vertical

Connections:
+3V3: JP1.1 (A), Q1.1 (G), R14.1
+BATT: J3.1, SW3.1 (A)
/3V3: C8.1, C17.1, JP1.2 (C), L2.2, RV2.1, TP2.1
/EncDebnc: C3.1, R6.2, U2.9
/LeftDebn: C7.1, R11.2, U2.3
/Load_3V3: JP1.3 (B), R12.1
/Load_VCC: JP2.3 (B), R13.1
/MidDebn: C11.1, R17.2, U2.5
/RigDebn: C12.1, R20.2, U2.1
/Vin: C1.1, C4.1, R5.1, R8.1, SW3.2 (B), U1.6 (Vin), U3.6 (Vin)
AD0_PC0: U2.8, U4.23 (PC0)
AD1_PC1: U2.2, U4.24 (PC1)
AD2_PC2: R3.2, SW1.1 (A), U4.25 (PC2)
AD3_PC3: R2.2, SW1.3 (C), U4.26 (PC3)
AD4_PC4: U4.27 (PC4)
AD5_PC5: U4.28 (PC5)
GND: C1.2, C2.2, C3.2, C4.2, C5.2, C6.2, C7.2, C8.2, C9.1, C10.1, C11.2, C12.2, C13.1, C14.1, C15.1, C16.2, C17.2, C18.1, D3.2 (A), D4.2 (A), J1.6, J2.1, J3.2, R7.2, R10.2, R12.2, R13.2, RV1.3, RV2.3, SW1.2 (B), SW2.2, SW4.C, SW4.MP, SW4.S2, SW5.1, SW6.1, SW7.1, SW8.1, TPG1.1, TPG2.1, U1.4 (GND), U2.7 (GND), U2.11, U2.13, U3.4 (GND), U4.8 (GND), U4.22 (GND)
IO0_RX_PD0: U4.2 (PD0)
IO1_TX_PD1: U4.3 (PD1)
IO2_PD2: R22.1, U4.4 (PD2)
IO3_PD3: R21.2, U4.5 (PD3)
IO4_PD4: U4.6 (PD4)
IO5_PD5: U2.4, U4.11 (PD5)
IO6_PD6: U2.6, U4.12 (PD6)
IO7_PD7: R1.2, SW2.1, U4.13 (PD7)
IO8_PB0: U4.14 (PB0)
IO9_PB1: Q1.3 (D), R16.2, U4.15 (PB1)
IO10_SS_PB2: U4.16 (PB2)
IO11_MOSI_PB3: J1.4, U4.17 (PB3)
IO12_MISO_PB4: J1.1, U4.18 (PB4)
IO13_SCK_PB5: J1.3, U4.19 (PB5)
LCD_RX: J2.6, Q1.2 (S), R14.2
unnamed: C2.1, U1.3 (TC)
unnamed: C5.1, U3.3 (TC)
unnamed: C9.2, U4.9 (XTAL1/PB6), Y1.1
unnamed: C10.2, U4.10 (XTAL2/PB7), Y1.2
unnamed: C13.2, U4.21 (AREF)
unnamed: C6.1, C16.1, JP2.2 (C), L1.2, RV1.1, TP1.1
unnamed: D1.1 (K), D4.1 (K), L1.1, U1.2 (SwE)
unnamed: D1.2 (A), R7.1
unnamed: D2.1 (K), D3.1 (K), L2.1, U3.2 (SwE)
unnamed: D2.2 (A), R10.1
unnamed: R4.2, R6.1, SW4.S1
unnamed: R5.2, U1.1 (SwC), U1.7 (Ipk), U1.8 (DC)
unnamed: R8.2, U3.1 (SwC), U3.7 (Ipk), U3.8 (DC)
unnamed: R9.2, R11.1, SW5.2
unnamed: R15.2, R17.1, SW6.2
unnamed: R19.2, R20.1, SW8.2
unnamed: R21.1, SW4.A
unnamed: R22.2, SW4.B
unnamed: RV1.2, U1.5 (Vfb)
unnamed: RV2.2, U3.5 (Vfb)
RESET#: J1.5, R18.2, SW7.2, U4.1 (~RESET/PC6)
VCC: C14.2, C15.2, C18.2, J2.2, JP2.1 (A), R1.1, R2.1, R3.1, R4.1, R9.1, R15.1, R16.1, R18.1, R19.1, U2.14 (VCC), U4.7 (VCC), U4.20 (AVCC)

Notes on the sheet:
Tilt Switch Trigger Rolling
Toggle Switch - Trigger Roll
Rotary Encoder for Dice Selection with Switch Debouncing Circuit
Use internal pullups
ICSP - Sparkfun Pocket AVR Programmer Provides +5V
Female Header for 16x2 LCD Screen Sparkfun RGB LCD Screen
ICSP 5V NC
5 V Regulator
3.3 V Regulator
Barrel Jack Center Positive
9V Battery Input
3 Momentary Switches for Dice Menu Controls with Debouncing Circuits
2 Unused Schmitt Trigger Inverters
5V to 3.3V Logic Level Shifter
Order Shunt for Selector
Reset Switch
Crystal for Clock
ATMEGA328P Controller Circuit

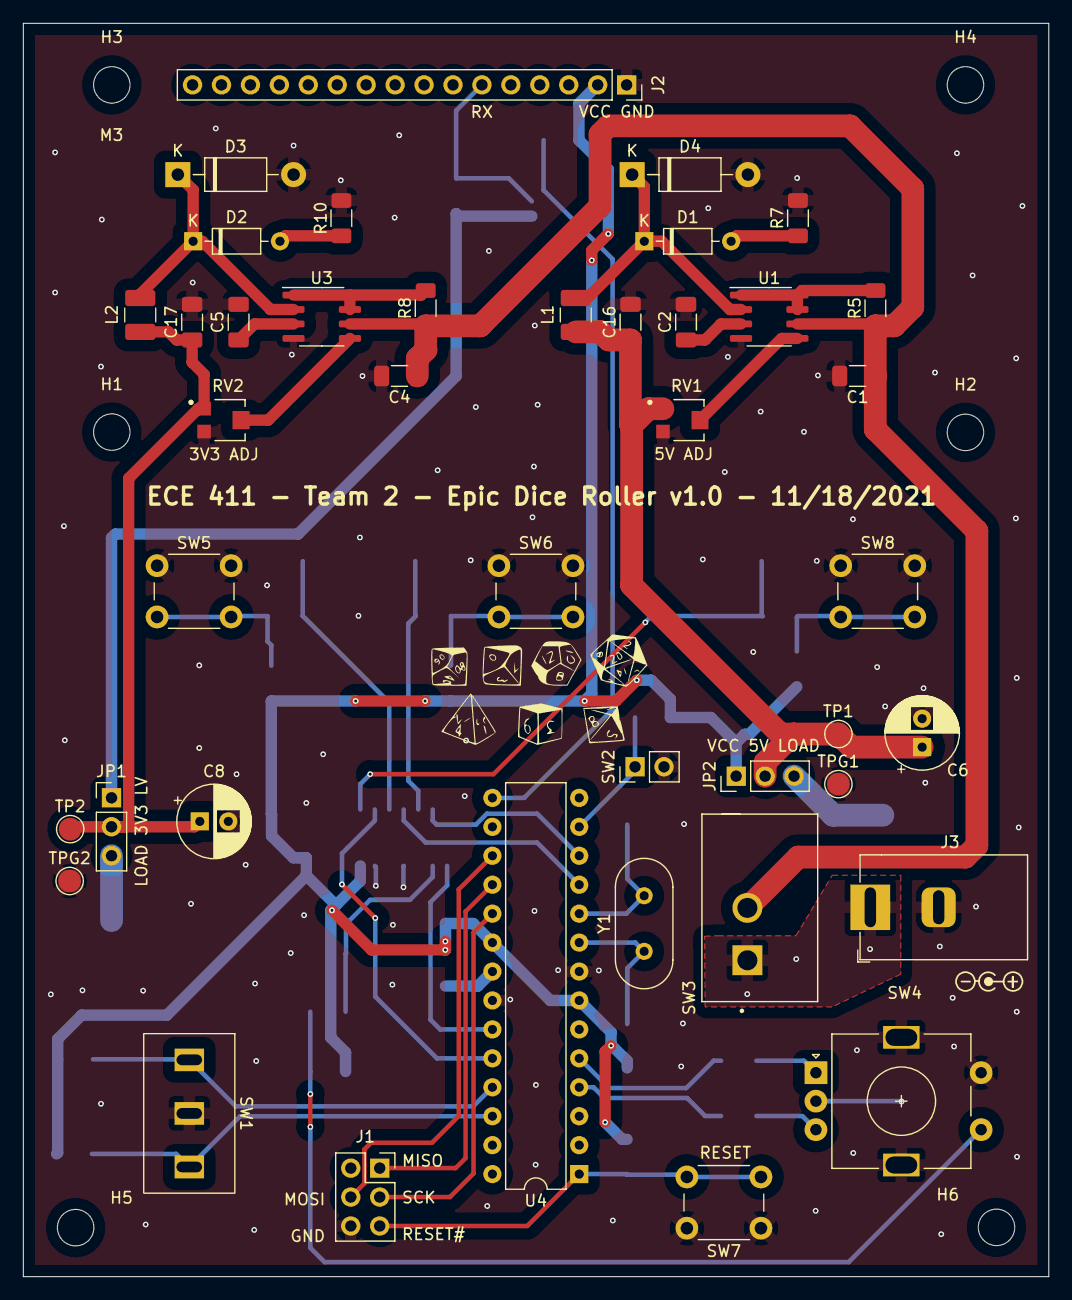
[picture p34: board Team2EpicDiceRoller.kicad_pcb from above]

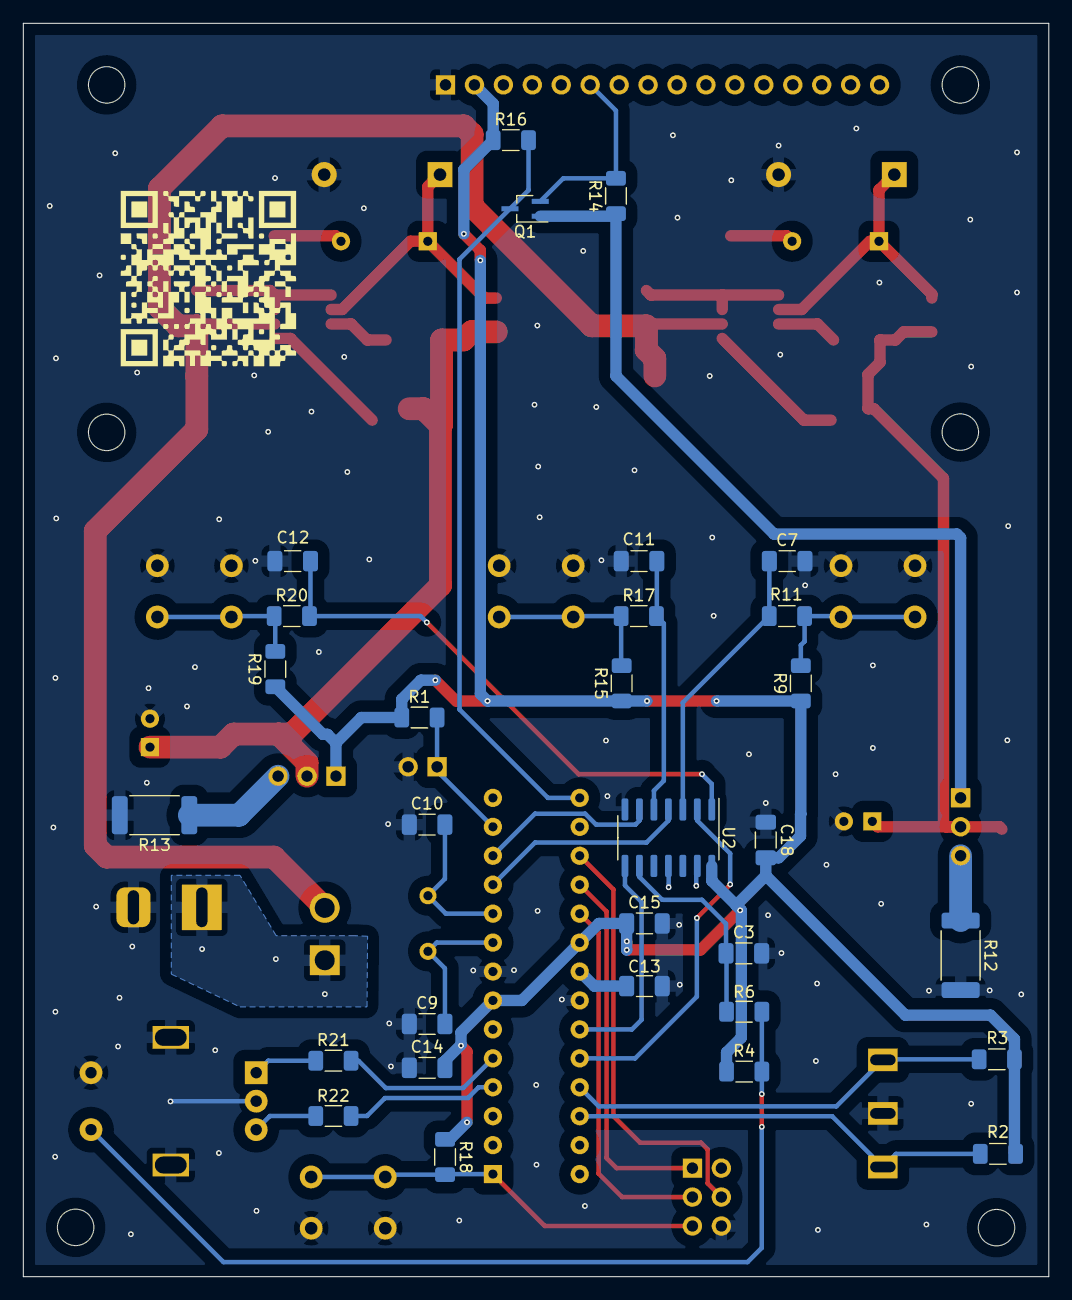
[picture p35: board Team2EpicDiceRoller.kicad_pcb from below]

Board: 2 copper layers, 90.0 x 110.0 mm, 77 parts (30 on the bottom side), 47 nets.
