ewerd/ECE_411_Team2_EpicDiceRoller/(commit log)

2021-10-27 Updated the voltage divider on BJT base
2021-10-28 Added initial schematic for the IO. Also contains basic circuitry for the controller
    [DiceRoller.kicad_pcb, DiceRoller.kicad_sch]
2021-10-28 name correction
    [IO.kicad_pcb]
2021-10-28 picture of basic breadboarding prototype
2021-11-04 Add combined KiCAD schematic
    [EpicDiceRoller.kicad_pcb, EpicDiceRoller.kicad_sch]
2021-11-08 Added Subsystems to CAD folder
    [IO.kicad_pcb, IO.kicad_sch, Power_Supply.kicad_pcb, Power_Supply.sch]
2021-11-08 Finished moving files and added current KiCAD schematic
    [IO.kicad_pcb, IO.kicad_sch, Power_Supply.kicad_pcb, Power_Supply.sch, Team2EpicDiceRoller.kicad_pcb, Team2EpicDiceRoller.kicad_sch]
2021-11-08 removed extranneous files from CAD backups
2021-11-10 Voltage regulator redesign
2021-11-10 Added switch and calibration jumper
    [Power_Supply.sch]
2021-11-10 Added power supply circuit, barrel jack, logic level shifter
    [Team2EpicDiceRoller.kicad_sch]
2021-11-10 Updated schematic
    [Team2EpicDiceRoller.kicad_sch]
2021-11-11 added footprints for electrolytic capacitor
    [Team2EpicDiceRoller.kicad_sch]
2021-11-11 updated zener diodes and resistor values
    [Team2EpicDiceRoller.kicad_sch]
2021-11-11 added testpoint footprints
    [Team2EpicDiceRoller.kicad_sch]
2021-11-11 Initial routing - done poorly, need to update power switch footprint
    [Team2EpicDiceRoller.kicad_pcb, Team2EpicDiceRoller.kicad_sch]
2021-11-15 Added renamed backup of unrouted PCB
2021-11-15 Added no traces version here
    [Team2EpicDiceRoller_NoTraces.kicad_pcb]
2021-11-15 Found better way, just global delete traces and zones
    [Team2EpicDiceRoller_NoTraces.kicad_pcb]
2021-11-16 Updated schematic to remove traces and update the footprints
    [Team2EpicDiceRoller.kicad_pcb, Team2EpicDiceRoller.kicad_sch]
2021-11-16 Added mounting holes for the standoffs
    [Team2EpicDiceRoller.kicad_pcb, Team2EpicDiceRoller.kicad_sch]
2021-11-16 Newer version
    [Team2EpicDiceRoller.kicad_pcb, Team2EpicDiceRoller.kicad_sch]
2021-11-16 Added cap, moved pots, many changes
    [Team2EpicDiceRoller.kicad_pcb, Team2EpicDiceRoller.kicad_sch]
2021-11-16 Updated silk screen, ready to route
    [Team2EpicDiceRoller.kicad_pcb, Team2EpicDiceRoller.kicad_sch]
2021-11-16 Removed references to ICSP power supply
2021-11-17 Added schottky diode, bypass for schmitt, updated footprints for inductor, fixed level shifter
    [Team2EpicDiceRoller.kicad_sch]
2021-11-17 missed the level shifter swap fix
    [Team2EpicDiceRoller.kicad_sch]
2021-11-17 Added note about internal pullups to rotary encoder
    [Team2EpicDiceRoller.kicad_sch]
2021-11-17 updated layout, footprints look good
    [Team2EpicDiceRoller.kicad_pcb, Team2EpicDiceRoller.kicad_sch]
2021-11-17 Added 3d models and screen footprint to library folder
2021-11-17 Added design rules example to import before sending to oshpark
    [osh-park-2-layer-kicad-5.99-drc-template.kicad_pcb, osh-park-2-layer-kicad-5.99-drc-template.kicad_sch]
2021-11-17 Replaced footprint for 470uF cap
    [Team2EpicDiceRoller.kicad_pcb, Team2EpicDiceRoller.kicad_sch]
2021-11-18 Added mounting holes, updated general layout of pcb for routing
    [Team2EpicDiceRoller.kicad_pcb, Team2EpicDiceRoller.kicad_sch]
2021-11-18 Updated pin selections for some of the io so that we can use the screen and the enableinterrupt library at the same time
    [Team2EpicDiceRoller.kicad_pcb, Team2EpicDiceRoller.kicad_sch]
2021-11-18 Added date to pcb
    [Team2EpicDiceRoller.kicad_pcb]
2021-11-18 Revert "Updated the IO again"
    This reverts commit 80c1a5cda0b79e003991432f29007fe40f1553a5.
    [Team2EpicDiceRoller.kicad_sch]
2021-11-18 Updated pcb with those changes
    [Team2EpicDiceRoller.kicad_pcb]
2021-11-18 minor changes to text
    [Team2EpicDiceRoller.kicad_pcb, Team2EpicDiceRoller.kicad_sch]
2021-11-18 flipped a few capacitors
    [Team2EpicDiceRoller.kicad_pcb]
2021-11-18 started route
    [Team2EpicDiceRoller.kicad_pcb]
2021-11-18 route in progress
    [Team2EpicDiceRoller.kicad_pcb, Team2EpicDiceRoller.kicad_sch]
2021-11-18 Found another issue, inductors silkscreen conflicted with capacitors
    [Team2EpicDiceRoller.kicad_pcb]
2021-11-18 added qr code and symbol for power supply jack
    [Team2EpicDiceRoller.kicad_pcb]
2021-11-18 updated pcb and added dice graphic
    [Team2EpicDiceRoller.kicad_pcb]
2021-11-18 Fixed DRC failures, tiny traces, circles on silkscreen holes
    [Team2EpicDiceRoller.kicad_pcb]
2021-11-18 final adjustments
    [Team2EpicDiceRoller.kicad_pcb]
2021-11-18 Build files and gerbers
    [Team2EpicDiceRoller-B_Cu.gbr, Team2EpicDiceRoller-B_Mask.gbr, Team2EpicDiceRoller-B_Paste.gbr, Team2EpicDiceRoller-B_Silkscreen.gbr, Team2EpicDiceRoller-Edge_Cuts.gbr, Team2EpicDiceRoller-F_Cu.gbr, Team2EpicDiceRoller-F_Mask.gbr, Team2EpicDiceRoller-F_Paste.gbr]
2021-12-08 Most recent iteration
    -Loaded dice option (Hold board upside down and roll with rotary button)
    -Complete reorganization and modularity implemented
    -No comments still, and one file (out of time to implement multiple files)
    -three methods of rolling
2021-12-09 added BOM
    [Bill of Materials.xlsx]
